xlyric/Pv-router/(threads)

Thread 1 (2020-04-04):

Have you add a look onto ESPEasy to link your work as a plugin ?

gmella, 2020-04-04:
Salut,

 I plan to setup a PV router on my installation. I like your repo and setup running on ESP.
Quite all of my ESP8266 are running on ESPEasy since it is very easy to connect new devices,defines rules and exchanges data over wifi domoticz included ;).  I just made a PR for a plugin for my Linky reading. During this work I wondered  if you thougth about such idea to include PV router support as a plugin to ESPEasy. Is that the case ?

Anyway, thank you for sharing your work! Merci !
( En fait j'ai modifié le plugin par defaut ADC internal pour garder les valeurs min-max du mode oversampling 50fois par s. Mais c'est pas très précis....)

xlyric, 2020-08-30:
Salut,
pour espeasy, j'ai aussi quelques IOT dessus , mais je connais pas leurs systèmes de plugins.
après perso, j'utilise maintenant plus tasmoda c'est plus simple à configurer.

désolé de pas avoir répondu plus tot, j'avais pas vu que j'avais une issue d'ouverte.

Closed 2021-03-17.

Thread 2 (2021-03-17):

yoyo effect

xlyric, 2021-03-17:
si la régulation est branché sur une forte charge ( par exemple 3KW )
l'appli ne peux faire la régulation ( 0> max > 0 )
c'est du au fait que l'application est réglé sur une charge de 1kw.

lors de la prochaine version, je tenterais de faire une mesure de la charge installée sur le régulateur pour
faire une extrapolation de la régulation.
