xlyric/Pv-router/pv-routeur/images.h

#define WiFi_Logo_width 60
#define WiFi_Logo_height 36
const uint8_t WiFi_Logo_bits[] PROGMEM = {
  0x00, 0x00, 0x00, 0x00, 0x00, 0x00, 0x00, 0x00, 0x00, 0x00, 0x00, 0xF8,
  0x00, 0x00, 0x00, 0x00, 0x00, 0x00, 0x80, 0xFF, 0x07, 0x00, 0x00, 0x00,
  0x00, 0x00, 0xE0, 0xFF, 0x1F, 0x00, 0x00, 0x00, 0x00, 0x00, 0xF8, 0xFF,
  0x7F, 0x00, 0x00, 0x00, 0x00, 0x00, 0xFC, 0xFF, 0xFF, 0x00, 0x00, 0x00,
  0x00, 0x00, 0xFE, 0xFF, 0xFF, 0x01, 0x00, 0x00, 0x00, 0x00, 0xFF, 0xFF,
  0xFF, 0x03, 0x00, 0x00, 0x00, 0xFC, 0xFF, 0xFF, 0xFF, 0xFF, 0x00, 0x00,
  0x00, 0xFF, 0xFF, 0xFF, 0x07, 0xC0, 0x83, 0x01, 0x80, 0xFF, 0xFF, 0xFF,
  0x01, 0x00, 0x07, 0x00, 0xC0, 0xFF, 0xFF, 0xFF, 0x00, 0x00, 0x0C, 0x00,
  0xC0, 0xFF, 0xFF, 0x7C, 0x00, 0x60, 0x0C, 0x00, 0xC0, 0x31, 0x46, 0x7C,
  0xFC, 0x77, 0x08, 0x00, 0xE0, 0x23, 0xC6, 0x3C, 0xFC, 0x67, 0x18, 0x00,
  0xE0, 0x23, 0xE4, 0x3F, 0x1C, 0x00, 0x18, 0x00, 0xE0, 0x23, 0x60, 0x3C,
  0x1C, 0x70, 0x18, 0x00, 0xE0, 0x03, 0x60, 0x3C, 0x1C, 0x70, 0x18, 0x00,
  0xE0, 0x07, 0x60, 0x3C, 0xFC, 0x73, 0x18, 0x00, 0xE0, 0x87, 0x70, 0x3C,
  0xFC, 0x73, 0x18, 0x00, 0xE0, 0x87, 0x70, 0x3C, 0x1C, 0x70, 0x18, 0x00,
  0xE0, 0x87, 0x70, 0x3C, 0x1C, 0x70, 0x18, 0x00, 0xE0, 0x8F, 0x71, 0x3C,
  0x1C, 0x70, 0x18, 0x00, 0xC0, 0xFF, 0xFF, 0x3F, 0x00, 0x00, 0x08, 0x00,
  0xC0, 0xFF, 0xFF, 0x1F, 0x00, 0x00, 0x0C, 0x00, 0x80, 0xFF, 0xFF, 0x1F,
  0x00, 0x00, 0x06, 0x00, 0x80, 0xFF, 0xFF, 0x0F, 0x00, 0x00, 0x07, 0x00,
  0x00, 0xFE, 0xFF, 0xFF, 0xFF, 0xFF, 0x01, 0x00, 0x00, 0xF8, 0xFF, 0xFF,
  0xFF, 0x7F, 0x00, 0x00, 0x00, 0x00, 0xFE, 0xFF, 0xFF, 0x01, 0x00, 0x00,
  0x00, 0x00, 0xFC, 0xFF, 0xFF, 0x00, 0x00, 0x00, 0x00, 0x00, 0xF8, 0xFF,
  0x7F, 0x00, 0x00, 0x00, 0x00, 0x00, 0xE0, 0xFF, 0x1F, 0x00, 0x00, 0x00,
  0x00, 0x00, 0x80, 0xFF, 0x07, 0x00, 0x00, 0x00, 0x00, 0x00, 0x00, 0xFC,
  0x00, 0x00, 0x00, 0x00, 0x00, 0x00, 0x00, 0x00, 0x00, 0x00, 0x00, 0x00,
  };

const uint8_t activeSymbole[] PROGMEM = {
    B00000000,
    B00000000,
    B00011000,
    B00100100,
    B01000010,
    B01000010,
    B00100100,
    B00011000
};

const uint8_t inactiveSymbole[] PROGMEM = {
    B00000000,
    B00000000,
    B00000000,
    B00000000,
    B00011000,
    B00011000,
    B00000000,
    B00000000
};

const uint8_t chauffe[] PROGMEM = {
    B10011110,
    B10011010,
    B10011010,
    B10011010,
    B10011010,
    B10011010,
    B10011010,
    B11111010
};

const uint8_t vmc[] PROGMEM = {
    B00001000,
    B11111011,
    B00000001,
    B11111111,
    B00000000,
    B01111110,
    B00000010,
    B00000110
};


const uint8_t no[] PROGMEM = {
    B00000000,
    B00000000,
    B00000000,
    B00000000,
    B00000000,
    B00000000,
    B00000000,
    B00000000
};

const unsigned char antenne_logo [] PROGMEM = {
  // '33688, 16x16px
   0x04,0x20, 
   0x06, 0x60,
   0x02,0x40, 
  0x13,0xc8, 
  0x9b, 0xd9, 
  0x9b,0xd9, 
  0x9b, 0xd9, 
  0x93,0xc9, 
  0x92,0x49,  
 0x86, 0x61, 
   0x84,0x21,
 0x80, 0x01,
 0x80, 0x01, 
  0x80, 0x01, 
 0x80, 0x01, 
  0x80, 0x01
};


const unsigned char antenne_logo2 [] PROGMEM = {
  // 'antenne, 16x16px
  0x00, 0x18, 0x00, 0x3c,  0x00, 0x6e, 0x18, 0x67, 0xb8, 0x43, 0xf0, 0xc1, 0xe0, 0xc0, 0x70,  0xc0, 
  0x38, 0x40, 0x1c, 0x60,   0x0e, 0x60,0x07,0x70, 0x03, 0xf8, 0x0e, 0xde, 0xfc, 0xff, 0xe0, 0x70
};

/*const unsigned char clean_16_16 [] PROGMEM = {
  // 'antenne, 16x16px
  0x00, 0x00, 0x00, 0x00,  0x00, 0x00, 0x00, 0x00, 0x00, 0x00, 0x00, 0x00, 0xe0, 0xc0, 0x00,  0xc0, 
  0x00, 0x00, 0x00, 0x00,   0x0e, 0x00,0x00,0x00, 0x00, 0x00, 0x00, 0x00, 0x00, 0x00, 0x00, 0x00
};*/
