xlyric/Pv-router/(commit log)

2019-07-22 Update 1.6
    - Add Oled Display ( IP, modes, Stat, Sending image)
    - Add Web Oscillo mode
    - Add tuning level and switch mode transmission
2019-12-31 Ajout de la page de configuration
    ajout d'une page html pour configurer en ligne ( beta )
2020-02-05 ajout du mode total autonome avec dimmer
    + rajout de message d'erreur dans serial
2020-02-22 Dimmer local
    Ajout du dimmer local sur carte V2 et V3
    sur port disponible
    message Serial en cas de non connection de la porteuse AC.
2020-03-25 rajout de doc et autre
    - rajout de doc.txt sur la carte
    - rajout du reglage de fuse en commande
    - rajout de deltaneg en commande
2020-04-04 correction bug fuse > 50%
    Correction du bug fuse sup à 50 pcent
    et réduction du temps entre 2 mesures lors d'une correction ( 10 secondes > 4s )
2020-06-12 correction problème création répertoire
    évite le renomage du répertoire lors des téléchargement d'un zip
    [domoticz.h, images.h, pv-routeur.ino]
2020-08-31 correction bug calcul + heure
    [pv-routeur.ino]
2021-03-21 correction documentation + modification résistance
    - correction visuelle
    - correction accès documentation
    - possibilité de modifier la valeur de charge connectée pour l'interpolation
    [pv-routeur.ino]
